autaut03/daikin-esp/pcb/hb-bob/kicad-src/hb-bob-r1p0.kicad_pcb

## KiCad design pcb/hb-bob/kicad-src/hb-bob-r1p0.kicad_pcb (2025-08-31)

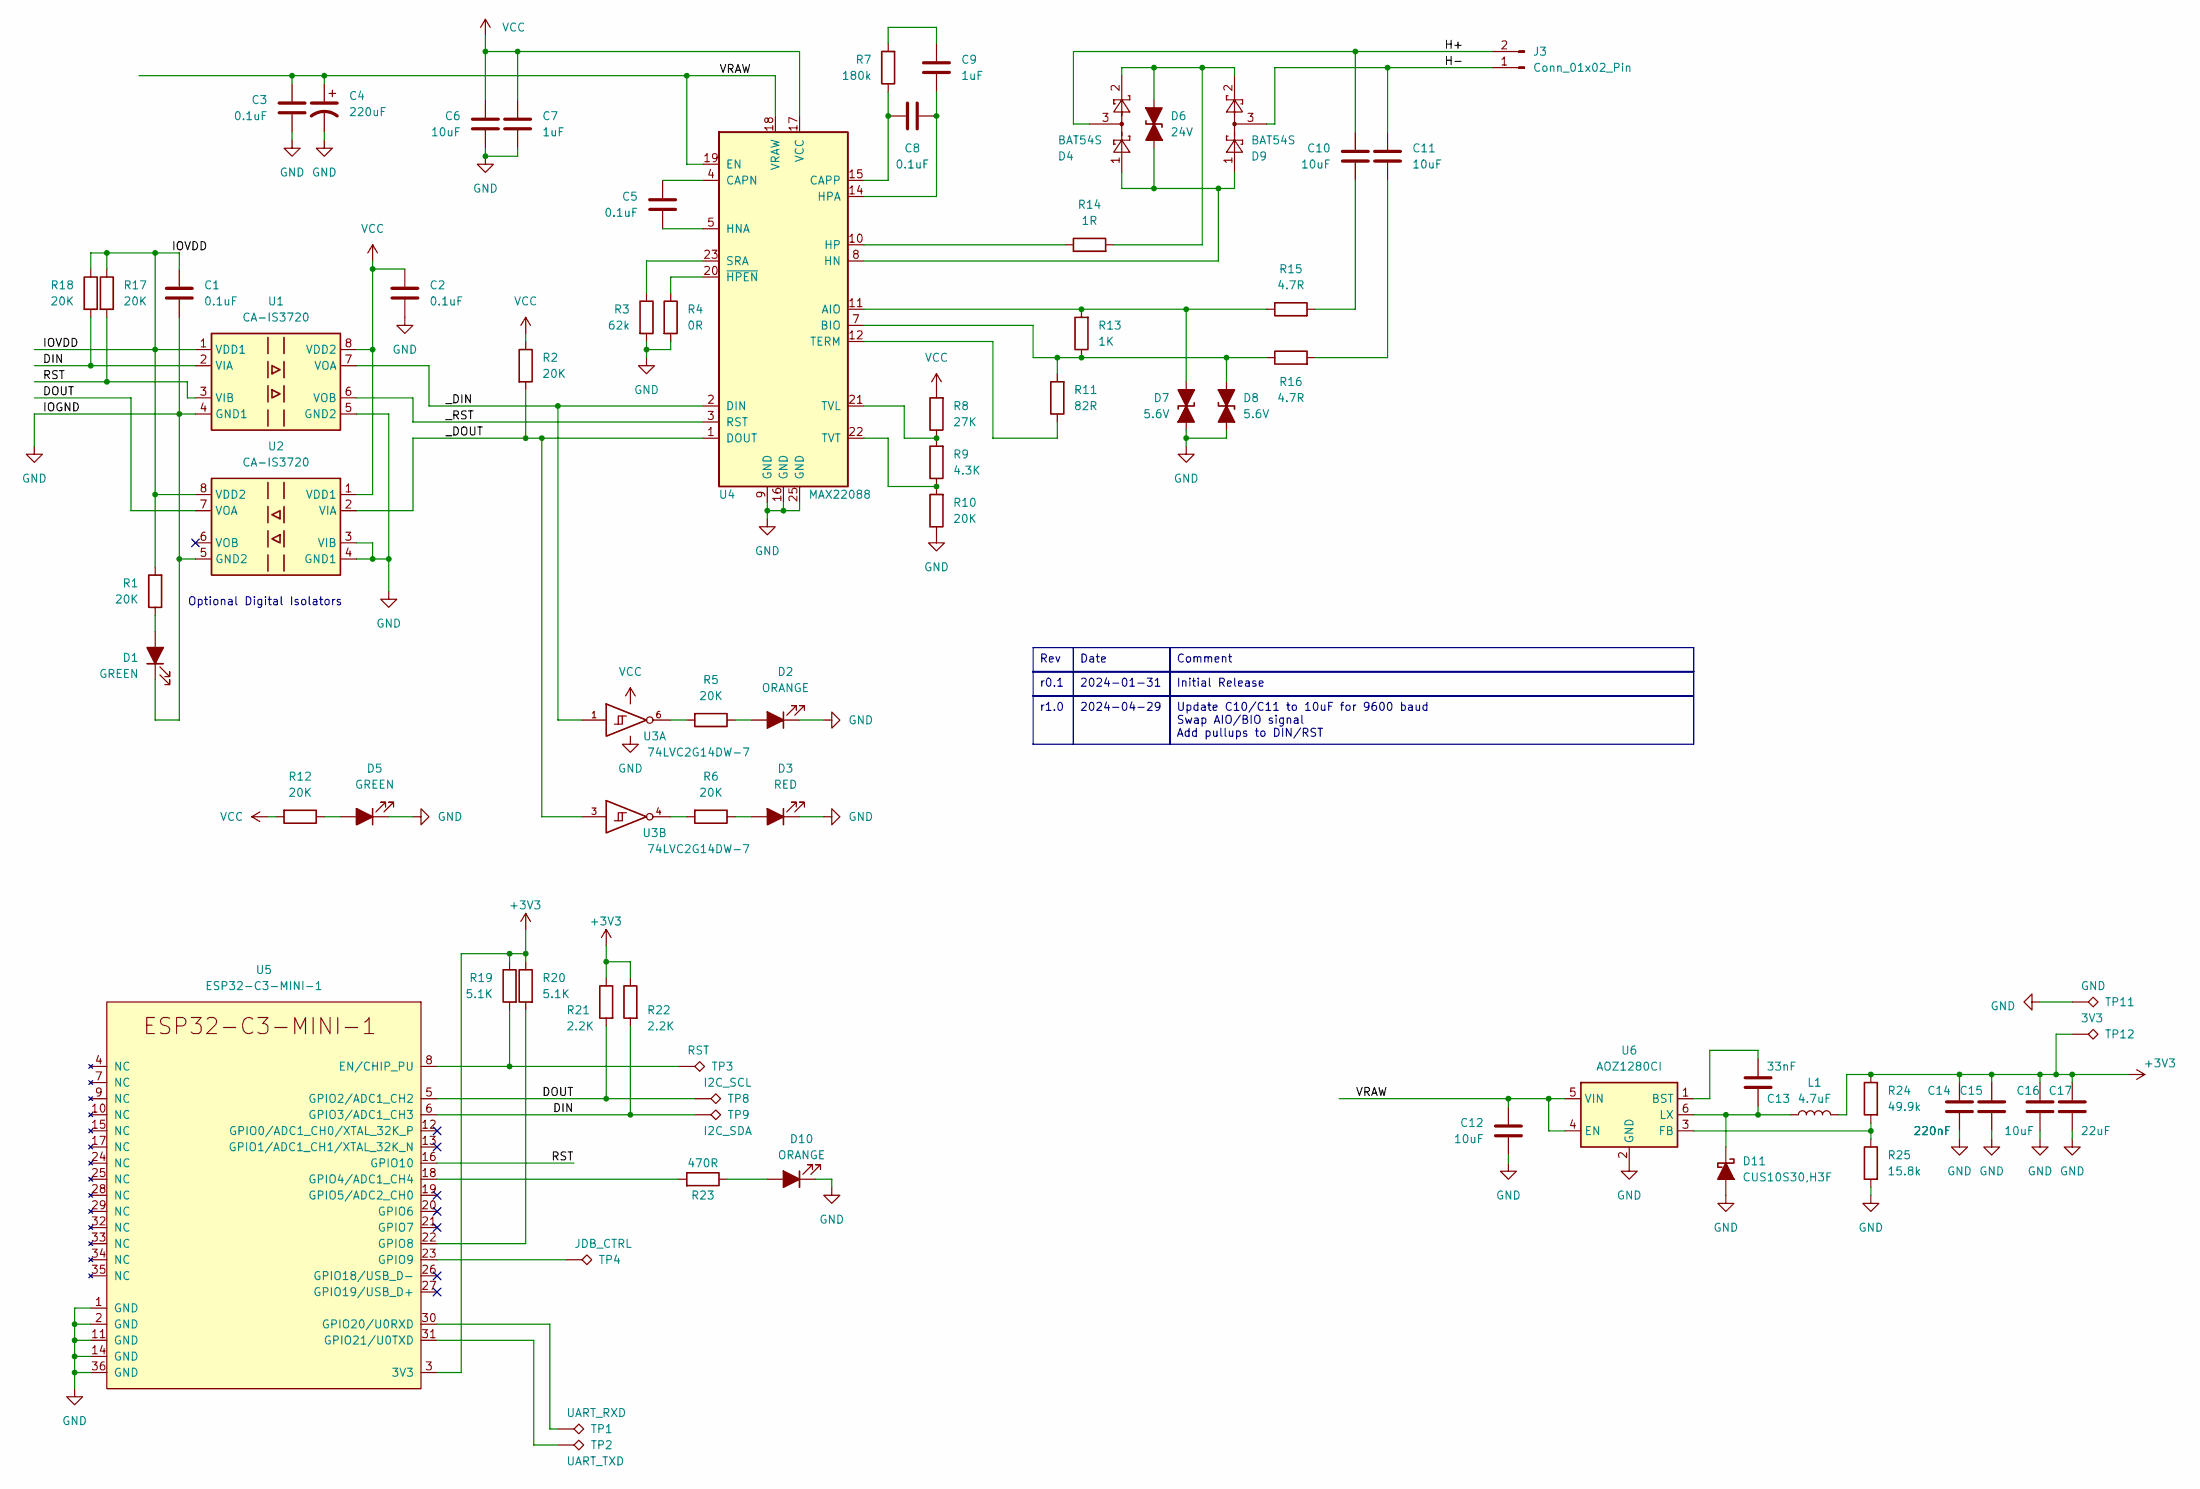
[picture p1: schematic hb-bob-r1p0.kicad_sch, HomeBus Breakout Board]

Parts:
C1, C2, C3, C5, C8: 0.1uF; C_0402_1005Metric; LCSC C1525
C4: 220uF; CP_EIA-7360-38_Kemet-E_Pad2.25x4.25mm_HandSolder; LCSC C2918361
C6, C10, C11: 10uF; C_0402_1005Metric; LCSC C15525
C7, C9: 1uF; C_0402_1005Metric; LCSC C52923
C12: 10uF; C_0603_1608Metric; LCSC C15850
C13: 33nF; C_0402_1005Metric; LCSC C106862
C14, C15: 220nF; C_0402_1005Metric; LCSC C16772
C16: 10uF; C_0603_1608Metric; LCSC C19702
C17: 22uF; C_0603_1608Metric; LCSC C59461
D1, D5: GREEN; LED_0402_1005Metric; LCSC C165980
D2: ORANGE; LED_0402_1005Metric; LCSC C165980
D3: RED; LED_0402_1005Metric; LCSC C165980
D4, D9: BAT54S; SOT-23; LCSC C916425
D6: 24V; D_SOD-123F; LCSC C908212
D7, D8: 5.6V; D_SOD-923; LCSC C151980
D10: ORANGE; LED_0402_1005Metric; LCSC C965791
D11: CUS10S30,H3F; D_SOD-523; LCSC C8523
J3: Conn_01x02_Pin; PinHeader_1x02_P2.54mm_Horizontal
L1: 4.7uF; L_0805_2012Metric; LCSC C63166
R1, R2, R5, R6, R10, R12, R17, R18: 20K; R_0402_1005Metric; LCSC C25765
R3: 62k; R_0402_1005Metric; LCSC C37825
R4: 0R; R_0402_1005Metric; LCSC C60485
R7: 180k; R_0402_1005Metric; LCSC C25760
R8: 27K; R_0402_1005Metric; LCSC C25771
R9: 4.3K; R_0402_1005Metric; LCSC C25899
R11: 82R; R_0402_1005Metric; LCSC C2909389
R13: 1K; R_0402_1005Metric; LCSC C11702
R14: 1R; R_0805_2012Metric; LCSC C131397
R15, R16: 4.7R; R_0603_1608Metric; LCSC C137705
R19, R20: 5.1K; R_0402_1005Metric; LCSC C25905
R21, R22: 2.2K; R_0402_1005Metric; LCSC C25879
R23: 470R; R_0402_1005Metric; LCSC C25117
R24: 49.9k; R_0402_1005Metric; LCSC C25897
R25: 15.8k; R_0402_1005Metric; LCSC C26956
TP1: UART_RXD; TestPoint_Pad_D1.0mm
TP2: UART_TXD; TestPoint_Pad_D1.0mm
TP3: RST; TestPoint_Pad_D1.0mm
TP4: JDB_CTRL; TestPoint_Pad_D1.0mm
TP8: I2C_SCL; TestPoint_Pad_D1.0mm
TP9: I2C_SDA; TestPoint_Pad_D1.0mm
TP11: GND; TestPoint_Pad_D1.0mm
TP12: 3V3; TestPoint_Pad_D1.0mm
U1, U2: CA-IS3720; SOIC-8_3.9x4.9mm_P1.27mm; LCSC C428882
U3: 74LVC2G14DW-7; SOT-363_SC-70-6; LCSC C362110
U4: MAX22088; QFN-24-1EP_4x4mm_P0.5mm_EP2.6x2.6mm; LCSC C5258925
U5: ESP32-C3-MINI-1; LCSC C2934569
U6: AOZ1280CI; SOT-23-6; LCSC C41240

Connections:
+3V3: C14.1, C15.1, C16.1, C17.1, L1.2, R19.1, R20.1, R21.1, R22.1, R24.1, TP12.1, U5.3 (3V3)
/DIN: R18.2, R22.2, TP9.1, U1.2 (VIA), U5.6 (GPIO3/ADC1_CH3)
/DOUT: R21.2, TP8.1, U2.7 (VOA), U5.5 (GPIO2/ADC1_CH2)
/H+: C10.2, D4.3, J3.2
/H-: C11.2, D9.3, J3.1
/IOVDD: C1.1, R1.2, R17.1, R18.1, U1.1 (VDD1), U2.8 (VDD2)
/RST: R17.2, U1.3 (VIB), U5.16 (GPIO10)
/VRAW: C3.1, C4.1, C12.1, U4.18 (VRAW), U4.19 (EN), U6.4 (EN), U6.5 (VIN)
/_DIN: U1.7 (VOA), U3.1, U4.2 (DIN)
/_DOUT: R2.2, U2.2 (VIA), U3.3, U4.1 (DOUT)
/_RST: U1.6 (VOB), U4.3 (RST)
GND: C1.2, C2.2, C3.2, C4.2, C6.2, C7.2, C12.2, C14.2, C15.2, C16.2, C17.2, D1.1 (K), D2.1 (K), D3.1 (K), D5.1 (K), D7.2 (A2), D8.2 (A2), D10.1 (K), D11.2 (A), R3.2, R4.2, R10.1, R25.2, TP11.1, U1.4 (GND1), U1.5 (GND2), U2.3 (VIB), U2.4 (GND1), U2.5 (GND2), U3.2 (GND), U4.9 (GND), U4.16 (GND), U4.25 (GND), U5.1 (GND), U5.2 (GND), U5.11 (GND), U5.14 (GND), U5.36 (GND), U5.37 (GND), U5.38 (GND), U5.39 (GND), U5.40 (GND), U5.41 (GND), U5.42 (GND), U5.43 (GND), U5.44 (GND), U5.45 (GND), U5.46 (GND), U5.47 (GND), U5.48 (GND), U5.49 (GND), U5.50 (GND), U5.51 (GND), U5.52 (GND), U5.53 (GND), U6.2 (GND)
unnamed: C9.1, R7.2
unnamed: C10.1, R15.2
unnamed: C11.1, R16.2
unnamed: D1.2 (A), R1.1
unnamed: D2.2 (A), R5.1
unnamed: D3.2 (A), R6.1
unnamed: D5.2 (A), R12.1
unnamed: D4.1, D6.1 (A1), D9.1, U4.8 (HN)
unnamed: D4.2, D6.2 (A2), D9.2, R14.2
unnamed: D7.1 (A1), R13.2, R15.1, U4.11 (AIO)
unnamed: D8.1 (A1), R11.2, R13.1, R16.1, U4.7 (BIO)
unnamed: D10.2 (A), R23.1
unnamed: C13.1, D11.1 (K), L1.1, U6.6 (LX)
unnamed: R5.2, U3.6
unnamed: R6.2, U3.4
unnamed: C5.1, U4.4 (CAPN)
unnamed: C8.2, R7.1, U4.15 (CAPP)
unnamed: C5.2, U4.5 (HNA)
unnamed: R14.1, U4.10 (HP)
unnamed: C8.1, C9.2, U4.14 (HPA)
unnamed: R3.1, U4.23 (SRA)
unnamed: R11.1, U4.12 (TERM)
unnamed: R8.1, R9.2, U4.21 (TVL)
unnamed: R9.1, R10.2, U4.22 (TVT)
unnamed: R4.1, U4.20 (~HPEN)
unnamed: R19.2, TP3.1, U5.8 (EN/CHIP_PU)
unnamed: R23.2, U5.18 (GPIO4/ADC1_CH4)
unnamed: R20.2, U5.22 (GPIO8)
unnamed: TP4.1, U5.23 (GPIO9)
unnamed: TP1.1, U5.30 (GPIO20/U0RXD)
unnamed: TP2.1, U5.31 (GPIO21/U0TXD)
unnamed: C13.2, U6.1 (BST)
unnamed: R24.2, R25.1, U6.3 (FB)
VCC: C2.1, C6.1, C7.1, R2.1, R8.2, R12.2, U1.8 (VDD2), U2.1 (VDD1), U3.5 (VCC), U4.17 (VCC)

Notes on the sheet:
Optional Digital Isolators
r0.1
2024-04-29
Initial Release
Update C10/C11 to 10uF for 9600 baud Swap AIO/BIO signal Add pullups to DIN/RST
Comment
Rev
2024-01-31
Date
r1.0

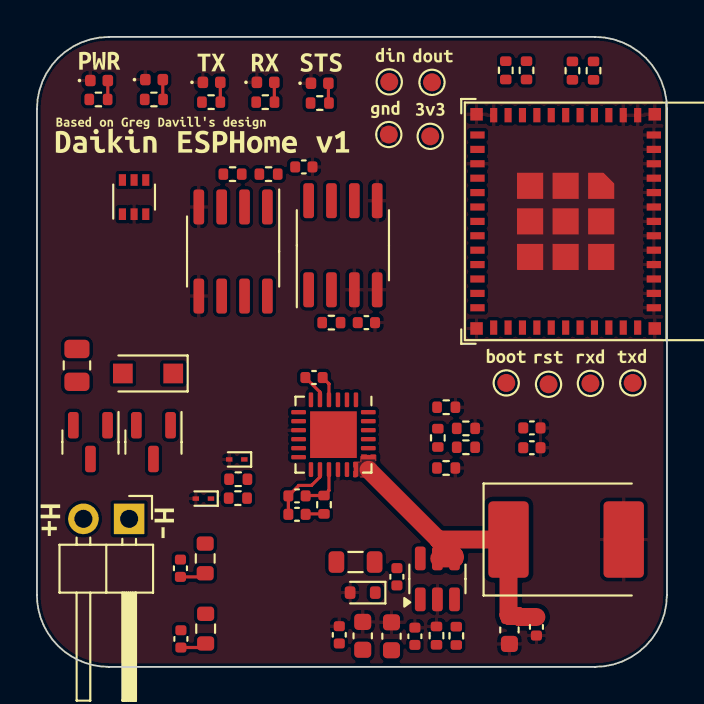
[picture p2: board hb-bob-r1p0.kicad_pcb from above]

Board: 2 copper layers, 35.0 x 35.0 mm, 85 parts (0 on the bottom side), 46 nets.

Other parts of the board:
kibuzzard-65B6C60D: G***; kibuzzard-65B6C60D
kibuzzard-65B6C61A: G***; kibuzzard-65B6C61A
kibuzzard-65B629C5: G***; kibuzzard-65B629C5
kibuzzard-65B629E6: G***; kibuzzard-65B629E6
kibuzzard-65B629EE: G***; kibuzzard-65B629EE
kibuzzard-68B31F11: G***; kibuzzard-68B31F11
kibuzzard-68B31F54: G***; kibuzzard-68B31F54
kibuzzard-68B31FE4: G***; kibuzzard-68B31FE4
kibuzzard-68B326CE: G***; kibuzzard-68B326CE
kibuzzard-68B326E4: G***; kibuzzard-68B326E4
kibuzzard-68B326FE: G***; kibuzzard-68B326FE
kibuzzard-68B3271E: G***; kibuzzard-68B3271E
kibuzzard-68B3273B: G***; kibuzzard-68B3273B
kibuzzard-68B32675: G***; kibuzzard-68B32675
kibuzzard-68B32731: G***; kibuzzard-68B32731
kibuzzard-68B32786: G***; kibuzzard-68B32786
